jhbruhn/ambika-smr4-multimode/hardware_design/pcb/Voicecard-SMRMU-v02.pdf

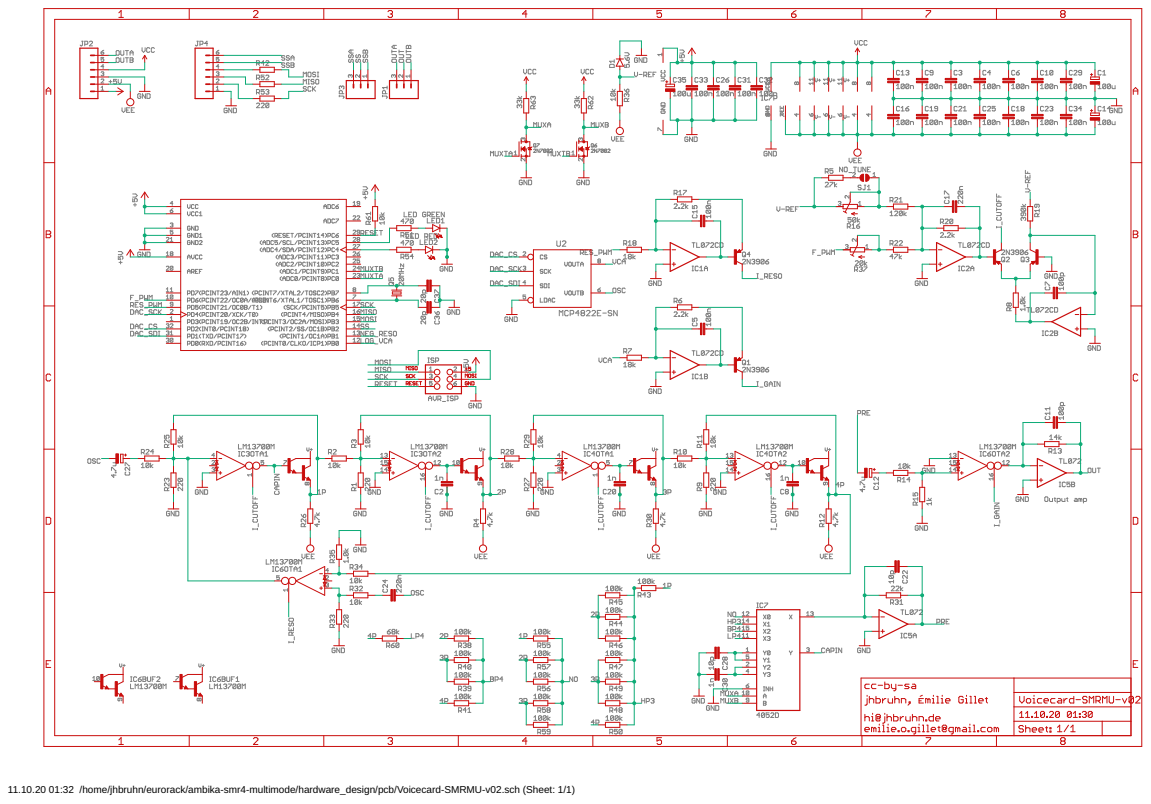
[picture p1: page 1]

11.10.20 01:32 /home/jhbruhn/eurorack/ambika-smr4-multimode/hardware_design/pcb/Voicecard-SMRMU-v02.sch (Sheet: 1/1)
