jhbruhn/ambika-smr4-multimode/simulations/simulation.pdf

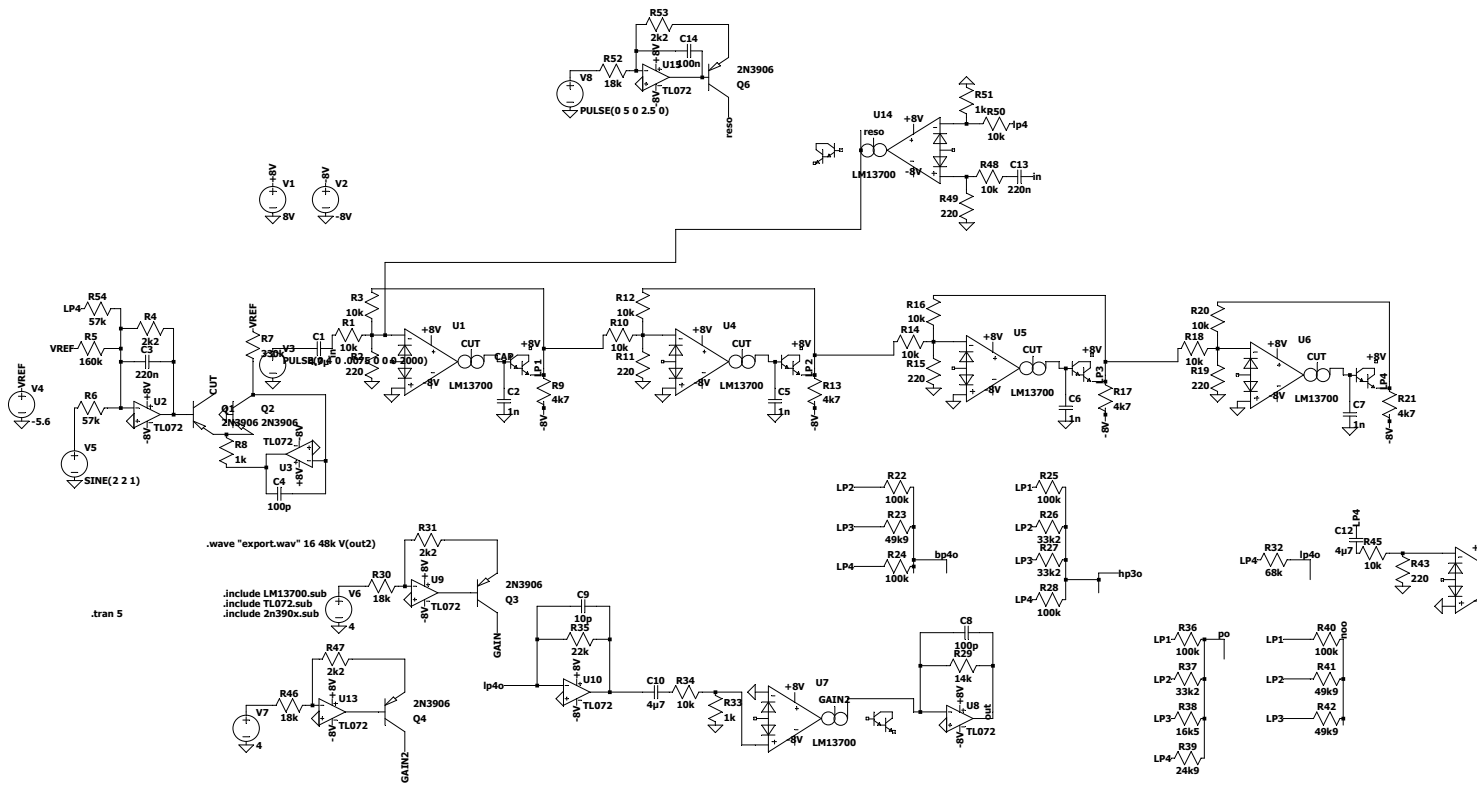
[picture p2: page 1]
