jhbruhn/ambika-smr4-multimode/simulations/multi.asc

C1: cap; 4.7µ
C2: cap; 1n
C3: cap; 220n
C4: cap; 100p
C5: cap; 1n
C6: cap; 1n
C7: cap; 1n
C8: cap; 100p
C9: cap; 10p
C10: cap; 4µ7
C11: cap; 100p
C12: cap; 4µ7
C13: cap; 220n
C14: cap; 100n
Q1: pnp; 2N3906
Q2: pnp; 2N3906
Q3: pnp; 2N3906
Q4: pnp; 2N3906
Q6: pnp; 2N3906
R1: res; 10k
R2: res; 220
R3: res; 10k
R4: res; 2k2
R5: res; 160k
R6: res; 57k
R7: res; 330k
R8: res; 1k
R9: res; 4k7
R10: res; 10k
R11: res; 220
R12: res; 10k
R13: res; 4k7
R14: res; 10k
R15: res; 220
R16: res; 10k
R17: res; 4k7
R18: res; 10k
R19: res; 220
R20: res; 10k
R21: res; 4k7
R22: res; 100k
R23: res; 49k9
R24: res; 100k
R25: res; 100k
R26: res; 33k2
R27: res; 33k2
R28: res; 100k
R29: res; 14k
R30: res; 18k
R31: res; 2k2
R32: res; 68k
R33: res; 1k
R34: res; 10k
R35: res; 22k
R36: res; 100k
R37: res; 33k2
R38: res; 16k5
R39: res; 24k9
R40: res; 100k
R41: res; 49k9
R42: res; 49k9
R43: res; 220
R44: res; 18k
R45: res; 10k
R46: res; 18k
R47: res; 2k2
R48: res; 10k
R49: res; 220
R50: res; 10k
R51: res; 1k
R52: res; 18k
R53: res; 2k2
R54: res; 57k
U1: LM13700
U2: opamp2; TL072
U3: opamp2; TL072
U4: LM13700
U5: LM13700
U6: LM13700
U7: LM13700
U8: opamp2; TL072
U9: opamp2; TL072
U10: opamp2; TL072
U11: LM13700
U12: opamp2; TL072
U13: opamp2; TL072
U14: LM13700
U15: opamp2; TL072
V1: voltage; 8V
V2: voltage; -8V
V3: voltage; PULSE(0 4 0 .0075 0 0 0 2000)
V4: voltage; -5.6
V5: voltage; SINE(2 2 1)
V6: voltage; 4
V7: voltage; 4
V8: voltage; PULSE(0 5 0 2.5 0)
Named nets: 0, +8V, -8V, CUT, VREF, LP1, LP2, LP3, LP4, in, bp4o, hp3o, lp4o, GAIN, out, po, noo, out2, GAIN2, reso, lp4, CAP
.include LM13700.sub
.include TL072.sub
.include 2n390x.sub
.wave "export.wav" 16 48k V(out2)
.tran 5
