jhbruhn/ambika-smr4-multimode/hardware_design/pcb/Voicecard-SMRMU-v03.sch

## EAGLE design hardware_design/pcb/Voicecard-SMRMU-v03.sch (2021-04-02)

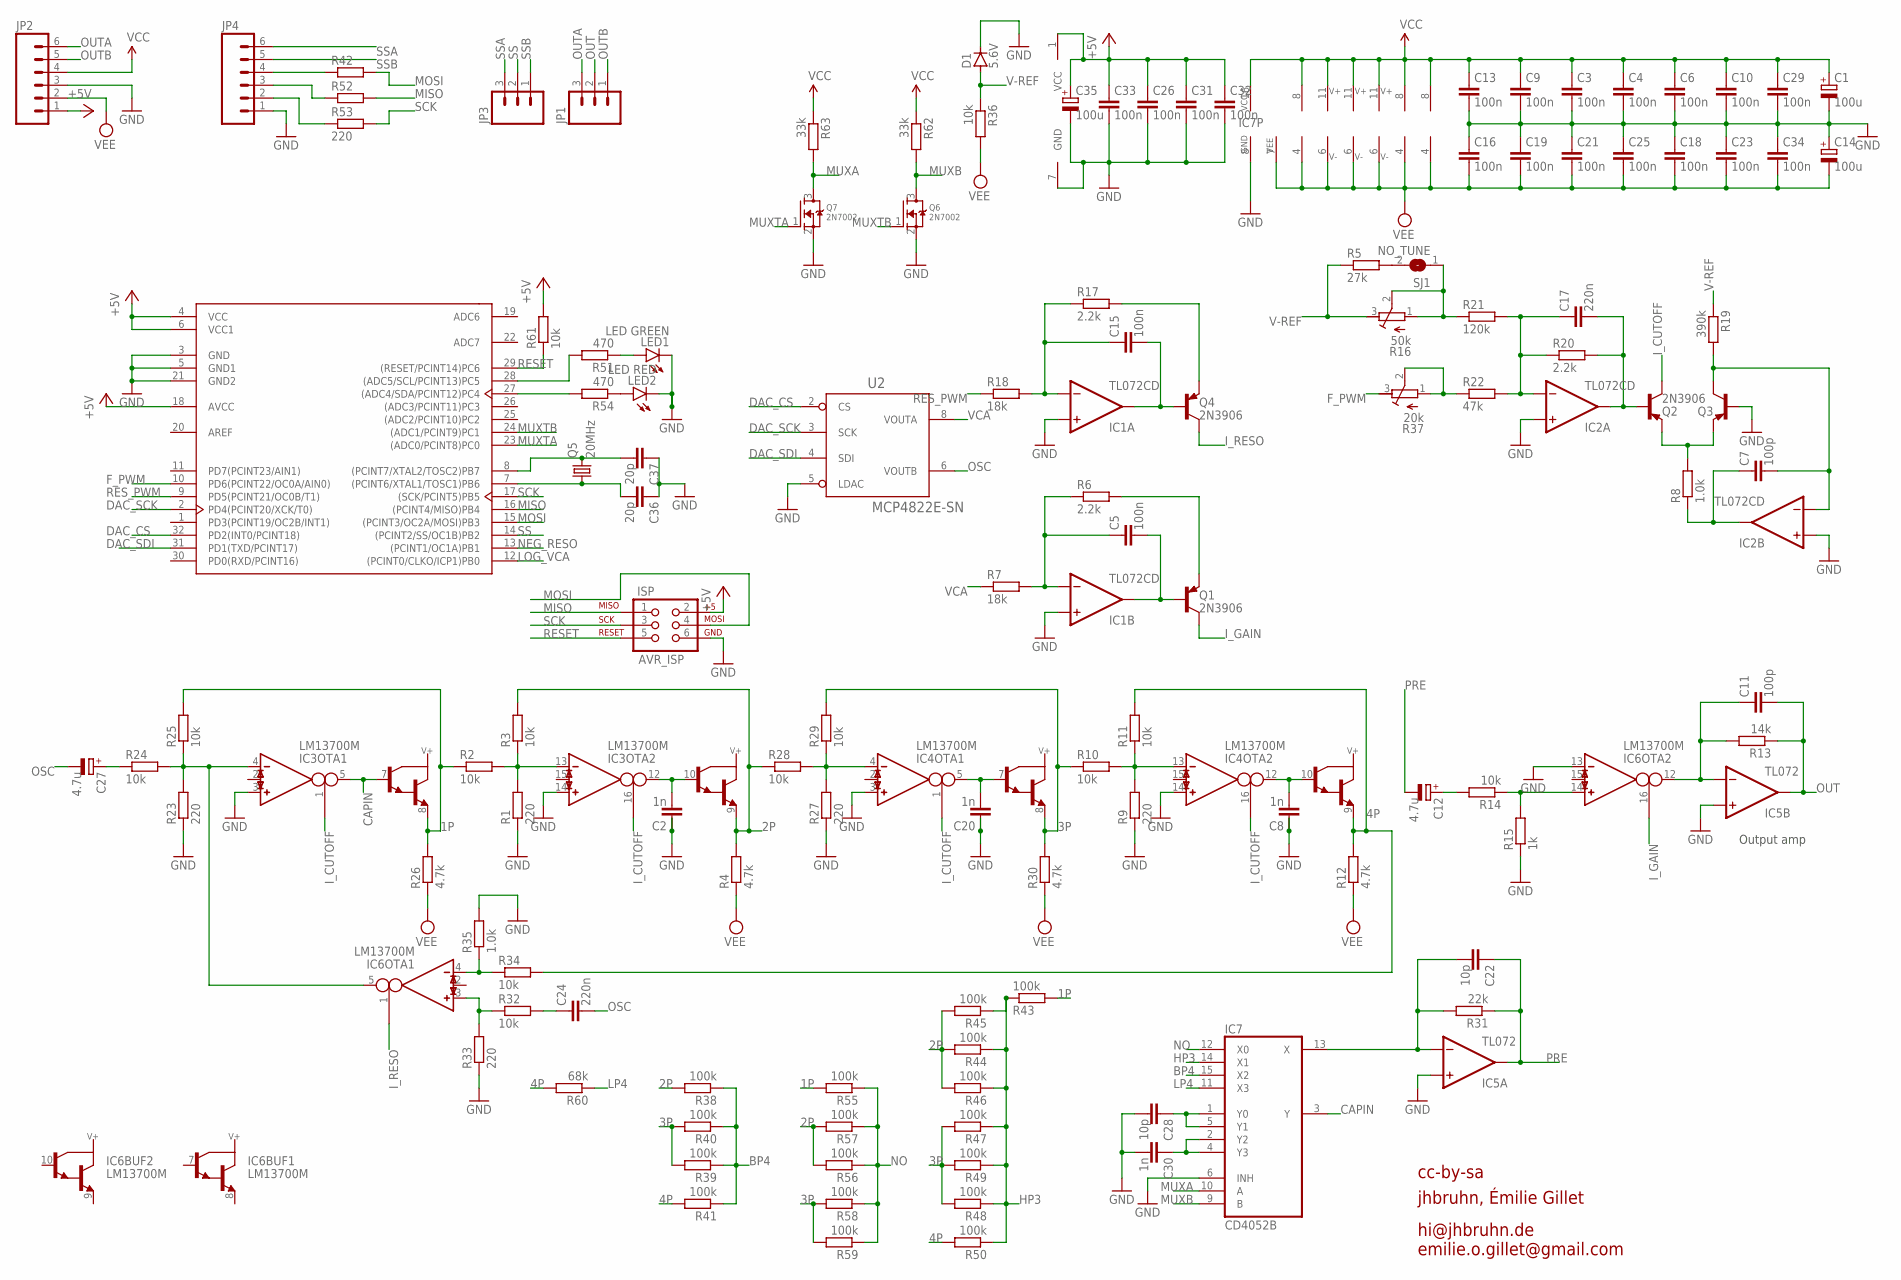
[picture p3: schematic Voicecard-SMRMU-v03.sch]

Parts:
C1, C14, C35: 100u; UD-6,3X7,7_NICHICON
C2, C8, C20, C30: 1n; C0603
C3, C4, C5, C6, C9, C10, C13, C15, C16, C18, C19, C21, C23, C25, C26, C29, C31, C32, C33, C34: 100n; C0603
C7, C11: 100p; C0603
C12, C27: 4.7u; UD-5X5,8_NICHICON
C17, C24: 220n; C0603
C22, C28: 10p; C0603
C36, C37: 20p; C0603
D1: 5.6V; MELF-MLL34
IC1, IC2: TL072CD; SOIC8
IC3, IC4, IC6: LM13700M; SO16
IC5: TL072; SOIC8
IC7: CD4052B; SOIC16N
ISP: AVR_ISP; 2X3
JP1, JP3: M03PTH; 1X03
JP2, JP4: M06SIP; 1X06
LED1: LED GREEN; CHIP-LED0603
LED2: LED RED; CHIP-LED0603
Q1, Q2, Q3, Q4: 2N3906; SOT23-BEC
Q5: 20MHz; HC49UP
Q6, Q7: 2N7002; SOT23
R1, R9, R23, R27, R33, R42, R52, R53: 220; R0603
R2, R3, R10, R11, R14, R24, R25, R28, R29, R32, R34, R36, R61: 10k; R0603
R4, R12, R26, R30: 4.7k; R0603
R5: 27k; R0603
R6, R17, R20: 2.2k; R0603
R7, R18: 18k; R0603
R8, R35: 1.0k; R0603
R13: 14k; R0603
R15: 1k; R0603
R16: 50k; RTRIM3296P
R19: 390k; R0603
R21: 120k; R0603
R22: 47k; R0603
R31: 22k; R0603
R37: 20k; RTRIM3296P
R38, R39, R40, R41, R43, R44, R45, R46, R47, R48, R49, R50, R55, R56, R57, R58, R59: 100k; R0603
R51, R54: 470; R0603
R60: 68k; R0603
R62, R63: 33k; R0603
SJ1: NO_TUNE; SJ
U1: ATMEGA328P-AU; TQFP-32
U2: MCP4822E-SN; SOIC8

Connections:
1P: IC3.8 (E), R2.1, R25.2, R26.2, R43.2, R55.2
2P: IC3.9 (E), R3.2, R4.2, R28.1, R38.2, R44.2, R45.2, R46.2, R56.2, R57.2
3P: IC4.8 (E), R10.1, R29.2, R30.2, R39.2, R40.2, R47.2, R48.2, R49.2, R58.2, R59.2
4P: IC4.9 (E), R11.2, R12.2, R34.2, R41.2, R50.2, R60.2
+5V: C26.1, C31.1, C32.1, C33.1, C35.+, ISP.2, JP2.1, R61.2, U1.4 (VCC), U1.6 (VCC1), U1.18 (AVCC), U2.1 (VCC)
BP4: IC7.15 (X2), R38.1, R39.1, R40.1, R41.1
CAPIN: IC3.5 (OUT), IC3.7 (B), IC7.3 (Y)
DAC_CS: U1.32 (PD2(INT0/PCINT18)), U2.2 (CS)
DAC_SCK: U1.2 (PD4(PCINT20/XCK/T0)), U2.3 (SCK)
DAC_SDI: U1.31 (PD1(TXD/PCINT17)), U2.4 (SDI)
F_PWM: R37.3 (E), U1.10 (PD6(PCINT22/OC0A/AIN0))
GND: C1.-, C2.1, C3.2, C4.2, C6.2, C8.1, C9.2, C10.2, C13.2, C14.+, C16.1, C18.1, C19.1, C20.1, C21.1, C23.1, C25.1, C26.2, C28.2, C29.2, C30.2, C31.2, C32.2, C33.2, C34.1, C35.-, C36.1, C37.1, D1.1 (C), IC1.3 (+IN), IC1.5 (+IN), IC2.3 (+IN), IC2.5 (+IN), IC3.3 (IN_P), IC3.14 (IN_P), IC4.3 (IN_P), IC4.14 (IN_P), IC5.3 (+IN), IC5.5 (+IN), IC6.13 (IN_N), IC7.6 (INH), IC7.8 (GND), ISP.6, JP2.3, JP4.1, LED1.C, LED2.C, Q3.B, Q6.2 (S), Q7.2 (S), R1.1, R9.1, R15.1, R23.1, R27.1, R33.1, R35.2, U1.3 (GND), U1.5 (GND1), U1.21 (GND2), U2.5 (LDAC), U2.7 (GND)
HP3: IC7.14 (X1), R43.1, R44.1, R45.1, R46.1, R47.1, R48.1, R49.1, R50.1
I_CUTOFF: IC3.1 (I_BIAS), IC3.16 (I_BIAS), IC4.1 (I_BIAS), IC4.16 (I_BIAS), Q2.C
I_GAIN: IC6.16 (I_BIAS), Q1.C
I_RESO: IC6.1 (I_BIAS), Q4.C
LOG_VCA: U1.12 ((PCINT0/CLKO/ICP1)PB0)
LP4: IC7.11 (X3), R60.1
MISO: ISP.1, R52.2, U1.16 ((PCINT4/MISO)PB4)
MOSI: ISP.4, R42.2, U1.15 ((PCINT3/OC2A/MOSI)PB3)
MUXA: IC7.10 (A), Q7.3 (D), R63.2
MUXB: IC7.9 (B), Q6.3 (D), R62.2
MUXTA: Q7.1 (G), U1.23 ((ADC0/PCINT8)PC0)
MUXTB: Q6.1 (G), U1.24 ((ADC1/PCINT9)PC1)
unnamed: Q2.E, Q3.E, R8.2
unnamed: C17.2, IC2.1 (OUT), Q2.B, R20.2
unnamed: C36.2, Q5.1, U1.7 ((PCINT6/XTAL1/TOSC1)PB6)
unnamed: C7.2, IC2.6 (-IN), Q3.C, R19.2
unnamed: C27.+, R24.1
unnamed: C28.1, IC7.1 (Y0), IC7.5 (Y1)
unnamed: LED1.A, R51.1
unnamed: JP4.2, R53.1
unnamed: C7.1, IC2.7 (OUT), R8.1
unnamed: LED2.A, R54.1
unnamed: R54.2, U1.27 ((ADC4/SDA/PCINT12)PC4)
unnamed: IC3.4 (IN_N), IC6.5 (OUT), R23.2, R24.2, R25.1
unnamed: JP4.3, R52.1
unnamed: C37.2, Q5.2, U1.8 ((PCINT7/XTAL2/TOSC2)PB7)
unnamed: C22.2, IC5.2 (-IN), IC7.13 (X), R31.2
unnamed: R16.1 (A), R16.2 (S), R21.1, SJ1.1
unnamed: IC3.13 (IN_N), R1.2, R2.2, R3.1
unnamed: JP4.4, R42.1
unnamed: C2.2, IC3.10 (B), IC3.12 (OUT)
unnamed: R51.2, U1.28 ((ADC5/SCL/PCINT13)PC5)
unnamed: IC4.4 (IN_N), R27.2, R28.2, R29.1
unnamed: C30.1, IC7.2 (Y2), IC7.4 (Y3)
unnamed: C20.2, IC4.5 (OUT), IC4.7 (B)
unnamed: IC4.13 (IN_N), R9.2, R10.2, R11.1
unnamed: R5.2, SJ1.2
unnamed: C12.+, R14.2
unnamed: C8.2, IC4.10 (B), IC4.12 (OUT)
unnamed: IC6.4 (IN_N), R34.1, R35.1
unnamed: C15.2, IC1.1 (OUT), Q4.B
unnamed: C5.2, IC1.7 (OUT), Q1.B
unnamed: C24.1, R32.2
unnamed: IC6.3 (IN_P), R32.1, R33.2
unnamed: IC6.14 (IN_P), R14.1, R15.2
unnamed: C17.1, IC2.2 (-IN), R20.1, R21.2, R22.2
unnamed: R22.1, R37.1 (A), R37.2 (S)
unnamed: C5.1, IC1.6 (-IN), R6.1, R7.2
unnamed: C15.1, IC1.2 (-IN), R17.1, R18.2
unnamed: Q4.E, R17.2
unnamed: Q1.E, R6.2
unnamed: C11.1, IC5.6 (-IN), IC6.12 (OUT), R13.2
NEG_RESO: U1.13 ((PCINT1/OC1A)PB1)
NO: IC7.12 (X0), R55.1, R56.1, R57.1, R58.1, R59.1
OSC: C24.2, C27.-, U2.6 (VOUTB)
OUT: C11.2, IC5.7 (OUT), JP1.2, R13.1
OUTA: JP1.3, JP2.6
OUTB: JP1.1, JP2.5
PRE: C12.-, C22.1, IC5.1 (OUT), R31.1
RESET: ISP.5, R61.1, U1.29 ((RESET/PCINT14)PC6)
RES_PWM: R18.1, U1.9 (PD5(PCINT21/OC0B/T1))
SCK: ISP.3, R53.2, U1.17 ((SCK/PCINT5)PB5)
SS: JP3.2, U1.14 ((PCINT2/SS/OC1B)PB2)
SSA: JP3.3, JP4.6
SSB: JP3.1, JP4.5
V-REF: D1.2 (A), R5.1, R16.3 (E), R19.1, R36.1
VCA: R7.1, U2.8 (VOUTA)
VCC: C1.+, C3.1, C4.1, C6.1, C9.1, C10.1, C13.1, C29.1, IC1.8 (V+), IC2.8 (V+), IC3.11 (V+), IC4.11 (V+), IC5.8 (V+), IC6.11 (V+), IC7.16 (VCC), JP2.4, R62.1, R63.1
VEE: C14.-, C16.2, C18.2, C19.2, C21.2, C23.2, C25.2, C34.2, IC1.4 (V-), IC2.4 (V-), IC3.6 (V-), IC4.6 (V-), IC5.4 (V-), IC6.6 (V-), IC7.7 (VEE), JP2.2, R4.1, R12.1, R26.1, R30.1, R36.2

Notes on the sheet:
cc-by-sa
Output amp
jhbruhn, Émilie Gillet
hi@jhbruhn.de emilie.o.gillet@gmail.com
