jhbruhn/ambika-smr4-multimode/(commit log)

2020-09-21 Add simulated circuit pdf
2020-09-21 Add Schematic files
    [Voicecard-SMRMU-v01.brd, Voicecard-SMRMU-v01.sch]
2020-09-23 Add boardlayout, assemblyfiles for v01 and pdf
    [Voicecard-SMRMU-v01.brd, Voicecard-SMRMU-v01.sch, Voicecard-SMRMU-v01_top_bom.csv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]
2020-10-10 hardware revision 2, fixes mode ordering, improves PCB design, adds cutoff offset tuning
    [Voicecard-SMRMU-v01.brd, Voicecard-SMRMU-v01.sch, Voicecard-SMRMU-v01_top_bom.csv, Voicecard-SMRMU-v02.sch, Voicecard-SMRMU-v02_top_bom.csv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]
2020-10-11 Update hardware design with new Q1 position
    [Voicecard-SMRMU-v02_top_cpl.csv]
2020-10-14 Update PCB with new pattern and optimized placements
    [Voicecard-SMRMU-v02_top_cpl.csv]
2020-12-05 Layout optimizations
    [Voicecard-SMRMU-v02.sch]
2021-04-02 Fix Multiplexer BOM Entry to use proper CMOS variant
    [Voicecard-SMRMU-v02.sch, Voicecard-SMRMU-v02_top_bom.csv]
2021-04-09 Move ISP Header to the left for improved clearance to the capacitor next to it. Fixes #2
    [Voicecard-SMRMU-v02.sch, Voicecard-SMRMU-v02_top_bom.csv, Voicecard-SMRMU-v03.sch, Voicecard-SMRMU-v03_top_bom.csv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]
